chuanqichen/Hardware-Accelerated-Monte-Carlo-Simulation/docs/course/README.md

# Course materials (not committed)

This folder holds the ECE 382M-7 Fall 2026 handouts and example reports used while
planning the project. They are gitignored (large PDFs, course-owned content); get
them from the course Canvas page and drop them here with these names so the links in
`../Hardware_Accelerated_Monte_Carlo_Project_Plan.md` resolve:

- `2026Fall_VLSI_I_Class_Project.pdf` - project brief / "Final Project Information"
- `Overview of 2025 Project Submissions as a Guide for Project Selections.pdf`
- `Example Project Proposal.pdf`
- `Example Project Interim Report.pdf`
- `All_Digital_Versus_Mixed_Signal_Phase_Locked_Loops.pdf` - prior-year report
- `Project_export.zip` - sample-project archive
