chuanqichen/Hardware-Accelerated-Monte-Carlo-Simulation/docs/status/2026-10-31_handoff.md

# Status / handoff - Saturday 2026-10-31 (Chuanqi)

Snapshot of where the Gaussian-LUT + fixed-point work stands, what is in flight, and
what to do next. Written so the work can be resumed cold on Monday.

## Done this weekend (all in PR #4, branch `chuanqi/round-sat-mc-pkg`)

PR: https://github.com/chuanqichen/Hardware-Accelerated-Monte-Carlo-Simulation/pull/4
Reviewers requested: Eric (ericjgoode), Shentong (binton508), Tyler (makowski537).

| Item | Where | Evidence |
|---|---|---|
| Shared `round_sat` module (round-half-even, then saturate, `sat` flag; signed/unsigned; SHIFT=0 ok) | `rtl/round_sat.sv` | `tb_round_sat`: 12,067 signed + 11,552 unsigned vectors, 0 errors; `+lint=all` clean |
| Python twin | `fxp.round_sat()` | 23 tests in `model/test_round_sat.py` |
| Vectors + TB + make targets | `model/gen_round_sat_vectors.py`, `tb/tb_round_sat.sv`, `make gen-rs` / `make sim-rs` | |
| `round_sat` substituted into `price_dp` S2 (patch in PR body; Eric's file NOT modified) | `/tmp/price_dp_rs.sv` on laptop + peach | `tb_price_dp` bit-exact at `MUL_STAGES` 1 and 2 |
| Shared constants package | `rtl/mc_pkg.sv` | elaborates clean with every RTL file; `lat_total(1,1,1) = 9` |
| Integrated one-lane golden model | `model/mc_lane.py` (`run_lane`, `trace_lane`, `run_option`, `LaneConfig`) | 11 tests in `model/test_mc_lane.py` |
| Spec refreshed to merged RTL | `docs/Lane_Interface_Spec.md` | D-3/D-6 closed 2026-10-22; D-4/D-5 open |
| First VCS run of every block on `main` | `reports/vcs_regression_2026-10-31.txt` | 69 model tests + 11 TB runs, all PASS |
| Lab-server recipe | `AGENTS.md` (ECE lab server section) | |
| `gauss_lut.sv` assertion labelled (`a_mag_positive`) | `rtl/gauss_lut.sv:74` | lint clean |

Bugs found by VCS, fixed, and now covered by directed vectors (worth a line in the report):
1. `round_sat`: cast-to-compare-width before shifting truncated the high input bits.
2. `round_sat`: unsigned max magnitude landed in the signed compare's sign bit.

## Environment

- **peach**: `ssh -i ~/.ssh/id_ed25519_ece cc83382@peach.ece.utexas.edu`; repo at
  `~/382M.7/Hardware-Accelerated-Monte-Carlo-Simulation` (on `main` 3c4169b + the PR
  files copied by scp - do a `git fetch && git checkout chuanqi/round-sat-mc-pkg` to
  make it a real checkout). Tools: `bash -l -c 'module load syn/2022 && ...'`.
  Python: `export PYTHON=/home/work/cc83382/venv/bin/python`. Home quota 2 GB - keep
  `simv*`/`csrc` cleaned up.
- **gh**: logged in as chuanqichen (HTTPS). `git push` still uses the macOS keychain.
- **Laptop**: no simulator; `make test`, `make gen*`, `make sweep` all work.

## Open questions raised in the PR

- Eric: PR #3 (revert of #2) opened and closed in 21 s on 2026-10-27 - is #2 good as merged?
- Tyler: no `mc_top`, controller, DC script or SDC in the repo yet. Week 2 exit
  criterion (bit-exact one-lane RTL) and all Week 3 synthesis depend on it.

## Monday 2026-11-02 agenda

1. Tyler status; fallback = minimal `mc_lane_top` (RNG -> LUT -> DP -> ACC) by Eric or me.
2. Announce all blocks pass under VCS on peach; share the `AGENTS.md` recipe.
3. D-4 (`z` 16 vs 12 b) and D-5 (`A`/`x` 18 vs 16 b): defer to Week 3 synthesis, or fix baseline now.
4. Who owns `mc_lane.py` going forward (me vs Eric).
5. Makefile: `PYTHON=` override; make the VCS targets not depend on `gen-price`.

## Next for me (Week 3, Nov 2-7)

- [ ] Get PR #4 reviewed and merged; help Eric apply the `round_sat` patch.
- [ ] Synthesize `gauss_lut` standalone on peach: `ADDR_BITS = {8, 10, 12}` x `OUT_WIDTH = {12, 16}`.
      Needs a DC script (Tyler's or write one) -> `results/gauss_lut_ppa.csv`, raw reports in `reports/`.
      Closes D-4.
- [ ] Extend the exact-bias sweep through quantised `x`, `S_T`, `p` for D-5. Check
      `price_dp.sweep()` first - it already does most of this; may only need joining with
      the `ADDR_BITS` sweep.
- [ ] Integrated one-lane TB vs `mc_lane.run_lane()` once a top exists (100 / 1k / 10k
      trials, bubbles, reset/restart, no X on valid-qualified buses).
- [ ] Interim slides (due Nov 10): block description, Sec. 6 exact-bias table,
      tail-truncation headline, standalone PPA, D-4/D-5 status, VCS pass log.

## Useful commands

```bash
# laptop
make test && make gen-rs
python3 model/mc_lane.py                 # 10^5-trial run vs exact / Black-Scholes
# peach (login shell)
module load syn/2022; export PYTHON=/home/work/cc83382/venv/bin/python
make test; make sim LATENCY=1; make sim-rs; make sim-price
rm -rf simv* csrc                        # keep the home quota happy
```

## Tyler merge checkpoint, 2026-11-01

PR #6 fixed the false-pass round_sat gate and is merged. Tyler approved PR #4 after
69 model tests, original rounding vectors, and four failing-input checks; #4 is
merged. PR #5 was reviewed, approved and merged as the shared synthesis baseline,
with pre-layout power/Fmax and electrical-signoff limits explicit in the review.

The one-lane integration is on tyler/one-lane-integration. Original Week 1 dirty
checkout is preserved. The combined branch passes 88 full-top cases / 105,828
trials, 100 bubble trials, 30 mock-control runs and both rounding configurations.
Local checks: 69 model tests and 12 flow/parser tests. Full-top shared-flow synthesis
has +0.000509739 ns setup slack at 5 ns, with hold/capacitance violations remaining.
See docs/Integration_Work_Plan.md and results/one_lane_shared_5ns.csv.

The candidate cfg rules and current one-lane-only limit are documented. Gate-level
simulation, independent STA, physical cleanup and real 2/4-lane scaling remain.
No physical timing/power signoff or energy claim is made. Codex is completing the
integration publication for Tyler; keep a single writer until that merge is done.

## Tyler PR #8 fix handoff, 2026-11-02

Writer: Tyler/Codex, local branch tyler/accuracy-wave-fixes in .worktrees/pr8-review,
starting at PR #8 head 5349d07. The waveform runner now fails closed, retains
per-run builds/logs and preserves old plotting inputs on failure. The accuracy
plot uses the confidence interval of the across-run mean and clarifies software
variance and exact-hardware coverage. CSV results and production RTL are unchanged.
Replot with python model/price_study.py --plot-only.

Checks: 79 model tests, 14 flow tests including 24 waveform failure cases, and
all three actual VCS waveform testbenches pass. See
reports/pr8_fix_validation_2026-11-02.txt for counts and the compiler-helper caveat.
Original dirty checkout and previous review evidence are preserved. Writer released
after the local commit; next action is publishing the fix branch for PR #8 review.
Nothing from this fix has been pushed, merged or approved remotely.

## Tyler interim checkpoint, 2026-11-11

Writer: Tyler/Codex on tyler/interim-integration-update in .worktrees/interim-update,
starting from main a83501c after PRs #8 and #10 merged. Original dirty Week 1 and
all earlier worktrees/evidence are preserved. Scope: interface-only mapped replay,
independent pre-layout STA, current integration docs and report contribution.

Verified: 85 model tests, 21 flow tests, fresh DC synthesis, and mapped replay of
22 cases / 26,457 trials. Corrupt sums, an empty corpus and an invalid SDC fail.
The important new limit is PrimeTime setup slack -0.200381 ns at the 5 ns target,
despite DC +0.000509739 ns. Hold/electrical/coverage issues also remain. See
reports/interim_validation_2026-11-11.txt and docs/Interim_Integration_Contribution.md.

Report assembly stays with Shentong; the Google Doc and Slack were read only.
Next: publish this isolated update for review, reconcile the timing discrepancy,
classify coverage and proceed with the proposed physical/multi-lane schedule.

## Shared report review, 2026-11-12

Tyler/Codex accepted Shentong's Slack invitation to edit the shared report directly.
The integration/synthesis claims were checked against PR #11's evidence, and the
feedback response now states exact-hardware CI coverage and conditional throughput.
The full-module screenshot was replaced with a short native baseline RTL excerpt;
seven equations and the responsibilities table were preserved. The final seven-page
PDF render was checked, including the fixed table/page flow. Shared source:
https://docs.google.com/document/d/1isvrOuPwzOCb3ohCs8GTmFbX7jLQcdSlMBD0RpaKZDk/edit

Repository edits are documentation only on tyler/interim-integration-update, after
7ff1989. Production source and evidence remain unchanged. No hardware tests were
repeated for report edits. No Slack message was sent. Writer released after this
handoff; Shentong retains report assembly and submission. PR #11 is still a draft;
the timing-engine discrepancy remains the next engineering task.

## Gaussian address clarification, 2026-11-13

Chuanqi requested the rationale and validation of the 10-bit address in Slack;
Tyler accepted. The shared report now explains `u[31:22]`, 1,024 bins and 512 stored
16-bit magnitudes, with the matched 8/10/12-bit full-chain bias and standalone area
tradeoff. All 15 relevant pricing rows reproduced; all 1,024 midpoint addresses and
the 11,029-vector corpus matched the model. Existing VCS evidence covers LATENCY
1 and 2; no new simulator run was needed. The rendered report remains seven pages,
with all seven equations and the responsibilities table preserved.

The report's accidental past-tense claim of multi-lane/layout completion was
restored to planned work. Scope is documentation only on
tyler/interim-integration-update after f05e4f0. The original dirty checkout, RTL and
result files remain untouched. Writer released; Shentong retains final report
assembly. No Slack message was sent. Timing reconciliation remains open.
