chuanqichen/Hardware-Accelerated-Monte-Carlo-Simulation/docs/figures/wave_price_dp.png

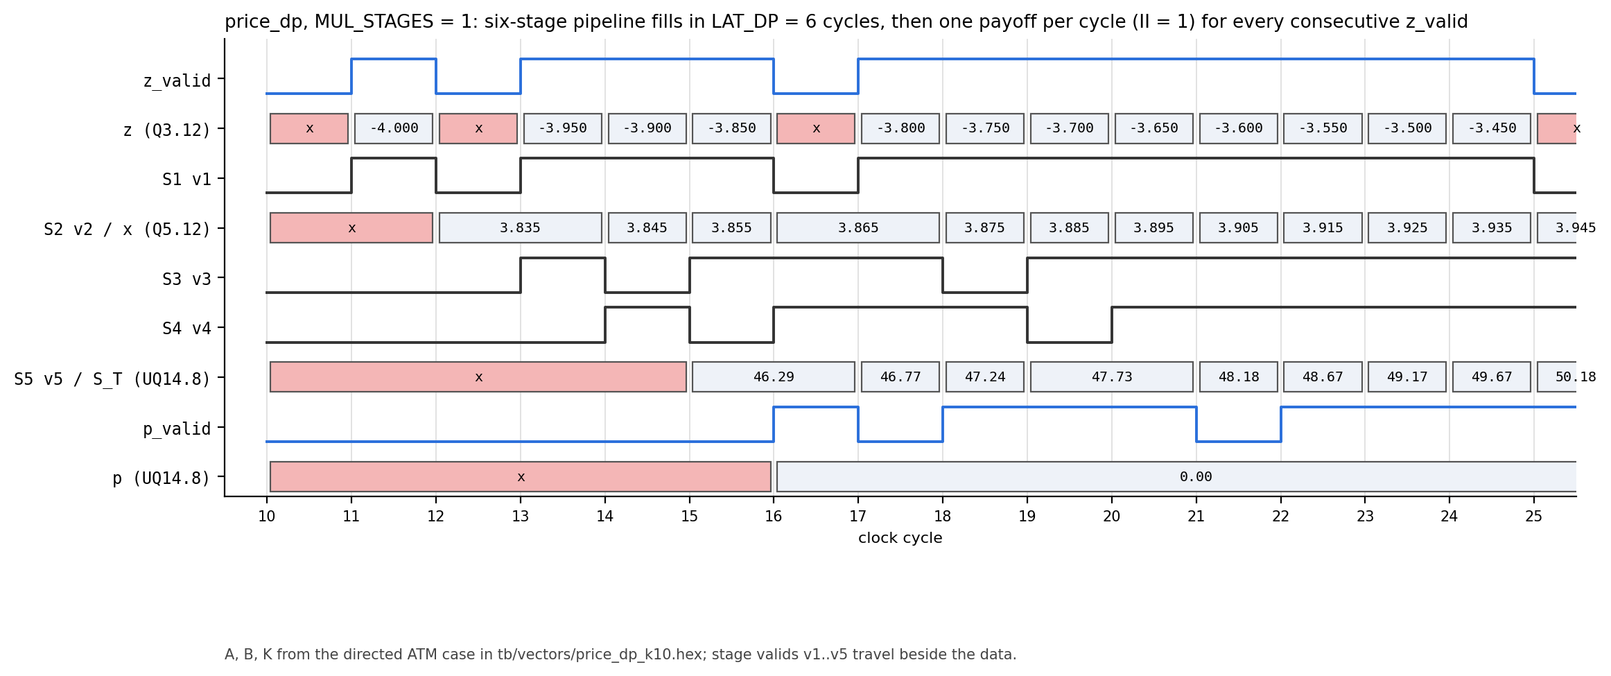
docs/figures/wave_price_dp.png
