chuanqichen/Hardware-Accelerated-Monte-Carlo-Simulation/docs/references/citation_validation_20260920_hardware_monte_carlo.md

# Citation validation report

Validated against the Crossref Works API on 2026-09-20. All 16 queried DOIs resolved with HTTP 200 and returned matching titles.

| DOI | Year | Title | Venue |
|---|---:|---|---|
| `10.1145/3447818.3461664` | 2021 | ThundeRiNG: Generating Multiple Independent Random Number Sequences on FPGAs | ACM International Conference on Supercomputing |
| `10.1109/EMS.2016.036` | 2016 | High Performance and Low Power Monte Carlo Methods to Option Pricing Models via High Level Design and Synthesis | European Modelling Symposium |
| `10.23919/DATE58400.2024.10546516` | 2024 | TreeGRNG: Binary Tree Gaussian Random Number Generator for Efficient Probabilistic AI Hardware | DATE |
| `10.1016/j.cpc.2026.110394` | 2026 | FPGA Acceleration of Matrix-Element Calculations for Monte Carlo Event Generation | Computer Physics Communications |
| `10.3390/electronics13163186` | 2024 | The Role of FPGAs in Modern Option Pricing Techniques: A Survey | Electronics |
| `10.1109/TC.2006.81` | 2006 | A Hardware Gaussian Noise Generator Using the Box-Muller Method and Its Error Analysis | IEEE Transactions on Computers |
| `10.1109/ASAP.2008.4580163` | 2008 | Low Discrepancy Sequences for Monte Carlo Simulations on Reconfigurable Platforms | ASAP |
| `10.1109/FPT.2014.7082755` | 2014 | FPGA-Accelerated Monte-Carlo Integration Using Stratified Sampling and Brownian Bridges | FPT |
| `10.1155/2012/675130` | 2012 | A Hardware Efficient Random Number Generator for Nonuniform Distributions with Arbitrary Precision | International Journal of Reconfigurable Computing |
| `10.1109/ReConFig.2011.11` | 2011 | An Energy Efficient FPGA Accelerator for Monte Carlo Option Pricing with the Heston Model | ReConFig |
| `10.7873/DATE.2013.063` | 2013 | A Multi-Level Monte Carlo FPGA Accelerator for Option Pricing in the Heston Model | DATE |
| `10.1145/1268776.1268777` | 2007 | TestU01: A C Library for Empirical Testing of Random Number Generators | ACM Transactions on Mathematical Software |
| `10.1145/2063384.2063405` | 2011 | Parallel Random Numbers: As Easy as 1, 2, 3 | SC |
| `10.18637/jss.v008.i14` | 2003 | Xorshift RNGs | Journal of Statistical Software |
| `10.1086/260062` | 1973 | The Pricing of Options and Corporate Liabilities | Journal of Political Economy |
| `10.1093/rfs/6.2.327` | 1993 | A Closed-Form Solution for Options with Stochastic Volatility with Applications to Bond and Currency Options | Review of Financial Studies |

The bundled citation-management validator could not parse the Crossref-generated one-line BibTeX entries and crashed after reporting zero parsed entries. DOI resolution and metadata matching were therefore verified directly through Crossref; the raw BibTeX output is preserved separately.
