chuanqichen/Hardware-Accelerated-Monte-Carlo-Simulation/results/d5_x_width.csv

addr_bits | x_fmt | x_width | x_frac | option | bs | float_ref | hw | bias_vs_float_pct | bias_vs_bs_pct
8 | Q5.12 (18b) | 18 | 12 | ITM K=80 s=0.2 | 24.58883544392775 | 24.574364829467598 | 24.582856457338757 | 0.03455482137620254 | -0.024315859133007704
8 | Q5.12 (18b) | 18 | 12 | ATM K=100 s=0.2 | 10.450583572185565 | 10.436192198016933 | 10.44189690189149 | 0.05466269465256274 | -0.08312138967239181
8 | Q5.12 (18b) | 18 | 12 | OTM K=120 s=0.2 | 3.247477416560809 | 3.2330305448533454 | 3.235320891580714 | 0.0708420998686355 | -0.37433747554645624
8 | Q5.12 (18b) | 18 | 12 | ATM K=100 s=0.6 | 25.523205665609503 | 25.383723336041815 | 25.380724521682083 | -0.011813926270908924 | -0.5582415696293254
8 | Q5.12 (18b) | 18 | 12 | OTM K=150 s=0.6 | 11.946999829891489 | 11.807134760276773 | 11.806226617083043 | -0.007691478179659427 | -1.1783143451314873
8 | Q5.11 (17b) | 17 | 11 | ITM K=80 s=0.2 | 24.58883544392775 | 24.574364829467598 | 24.581230821115245 | 0.027939650506913057 | -0.030927136951426366
8 | Q5.11 (17b) | 17 | 11 | ATM K=100 s=0.2 | 10.450583572185565 | 10.436192198016933 | 10.442404913211337 | 0.059530478900007455 | -0.07826030879265793
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
