chuanqichen/Hardware-Accelerated-Monte-Carlo-Simulation/results/rng_20261108_lags.csv

origin | stream | seed_bus | lag | correlation | screen_limit
imported_hex_canonical_checked | 0 | 0123456789abcdef0fedcba987654321 | 1 | 0.0005725882247458853 | 0.005859377793969722
imported_hex_canonical_checked | 0 | 0123456789abcdef0fedcba987654321 | 2 | 0.0005087849146128293 | 0.005859380587943441
imported_hex_canonical_checked | 0 | 0123456789abcdef0fedcba987654321 | 4 | 0.0011368024305010054 | 0.00585938617590287
imported_hex_canonical_checked | 0 | 0123456789abcdef0fedcba987654321 | 8 | 0.0008482255705019332 | 0.005859397351869689
imported_hex_canonical_checked | 0 | 0123456789abcdef0fedcba987654321 | 16 | -0.0005303004954892163 | 0.005859419703995179
imported_hex_canonical_checked | 1 | a21ddd67452a68254e0d1fe67c4a7a02 | 1 | 0.0015552892225936363 | 0.005859377793969722
imported_hex_canonical_checked | 1 | a21ddd67452a68254e0d1fe67c4a7a02 | 2 | 0.0007816454274062214 | 0.005859380587943441
imported_hex_canonical_checked | 1 | a21ddd67452a68254e0d1fe67c4a7a02 | 4 | -0.0015023908261074506 | 0.00585938617590287
imported_hex_canonical_checked | 1 | a21ddd67452a68254e0d1fe67c4a7a02 | 8 | 0.0008921478687228803 | 0.005859397351869689
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
