chuanqichen/Hardware-Accelerated-Monte-Carlo-Simulation/results/rng_model_bits.csv

origin | stream | seed_bus | bit | ones | fraction | z_score
python_model | 0 | 0123456789abcdef0fedcba987654321 | 0 | 523403 | 0.49915599822998047 | -1.728515625
python_model | 0 | 0123456789abcdef0fedcba987654321 | 1 | 524130 | 0.4998493194580078 | -0.30859375
python_model | 0 | 0123456789abcdef0fedcba987654321 | 2 | 524181 | 0.49989795684814453 | -0.208984375
python_model | 0 | 0123456789abcdef0fedcba987654321 | 3 | 524053 | 0.49977588653564453 | -0.458984375
python_model | 0 | 0123456789abcdef0fedcba987654321 | 4 | 524504 | 0.5002059936523438 | 0.421875
python_model | 0 | 0123456789abcdef0fedcba987654321 | 5 | 524439 | 0.5001440048217773 | 0.294921875
python_model | 0 | 0123456789abcdef0fedcba987654321 | 6 | 525504 | 0.50115966796875 | 2.375
python_model | 0 | 0123456789abcdef0fedcba987654321 | 7 | 524046 | 0.4997692108154297 | -0.47265625
python_model | 0 | 0123456789abcdef0fedcba987654321 | 8 | 524018 | 0.4997425079345703 | -0.52734375
python_model | 0 | 0123456789abcdef0fedcba987654321 | 9 | 523985 | 0.4997110366821289 | -0.591796875
python_model | 0 | 0123456789abcdef0fedcba987654321 | 10 | 524933 | 0.500615119934082 | 1.259765625
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
