chuanqichen/Hardware-Accelerated-Monte-Carlo-Simulation/results/rng_20261108_quality.png

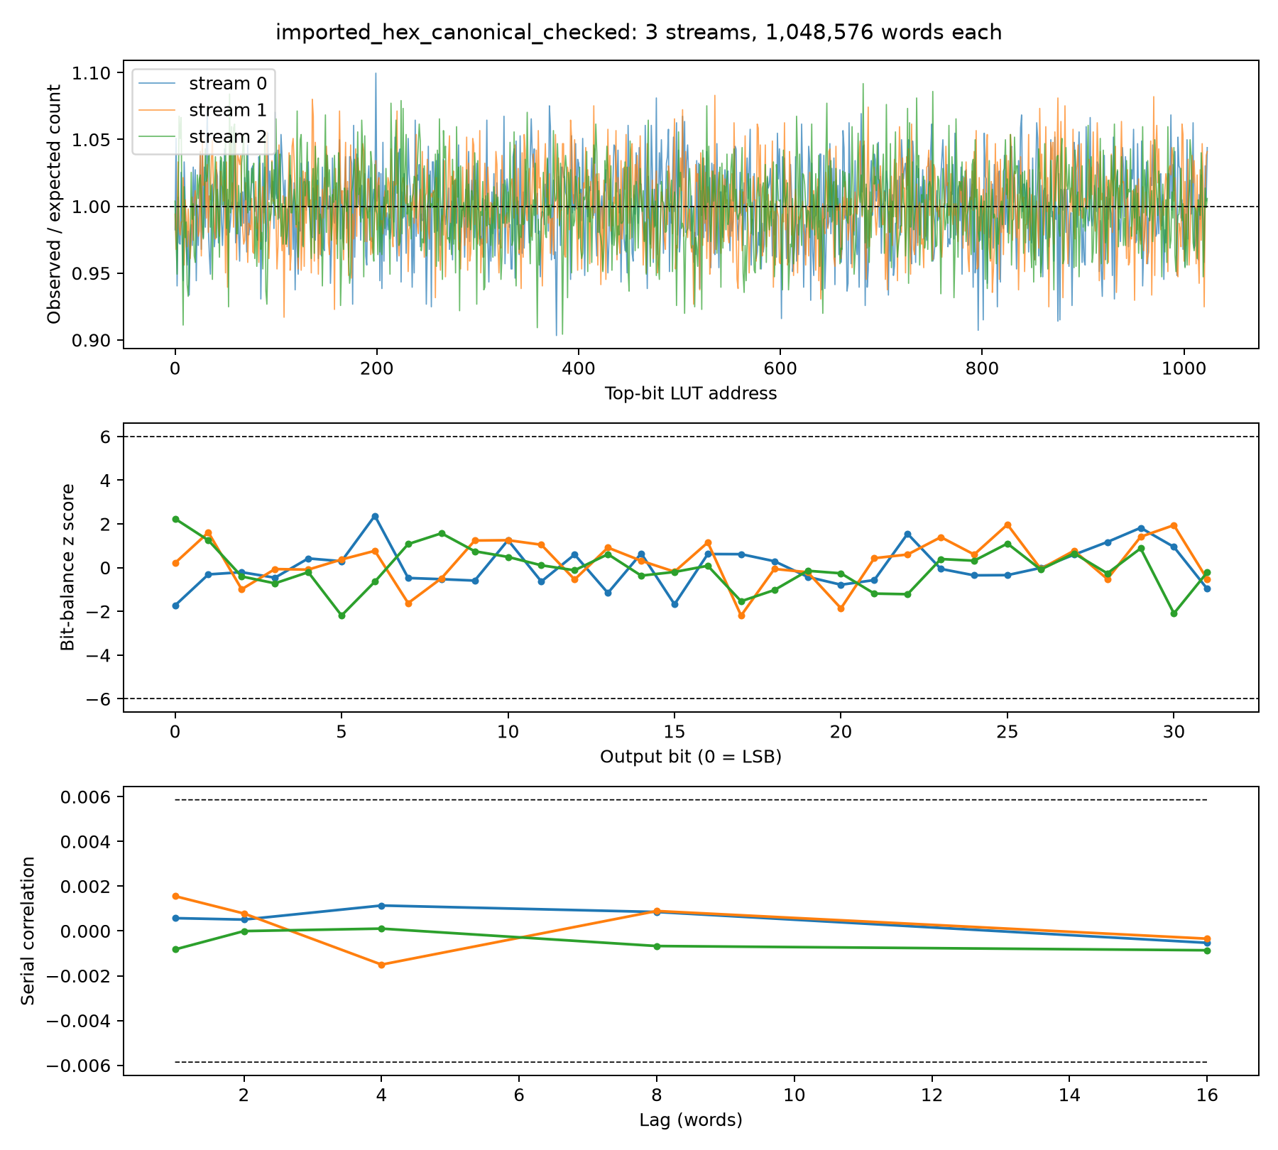
results/rng_20261108_quality.png
