chuanqichen/Hardware-Accelerated-Monte-Carlo-Simulation/reports/syn/gauss_lut_a10_w12_l1/gauss_lut.mapped.v

/////////////////////////////////////////////////////////////
// Created by: Synopsys DC Ultra(TM) in wire load mode
// Version   : T-2022.03-SP2
// Date      : Sun Nov  1 06:37:22 2026
/////////////////////////////////////////////////////////////


module gauss_lut_rom_ADDR_BITS10_OUT_WIDTH12 ( j, mag );
  input [8:0] j;
  output [11:0] mag;
  wire   n1112, n1113, n1114, n1115, n1, n2, n3, n4, n5, n6, n7, n8, n9, n10,
         n11, n12, n13, n14, n15, n16, n17, n18, n19, n20, n21, n22, n23, n24,
         n25, n26, n27, n28, n29, n30, n31, n32, n33, n34, n35, n36, n37, n39,
         n40, n41, n42, n43, n44, n45, n47, n49, n51, n53, n54, n55, n57, n59,
         n60, n61, n62, n63, n64, n65, n67, n68, n70, n72, n73, n75, n76, n78,
         n79, n81, n82, n84, n85, n87, n88, n89, n90, n91, n92, n93, n94, n95,
         n96, n97, n98, n99, n100, n101, n102, n103, n104, n105, n106, n107,
         n108, n109, n110, n111, n112, n114, n115, n116, n117, n119, n122,
         n124, n125, n127, n128, n129, n130, n132, n133, n135, n136, n137,
         n138, n139, n142, n144, n146, n148, n149, n150, n151, n152, n153,
         n154, n155, n156, n157, n158, n159, n160, n161, n162, n163, n164,
         n165, n166, n167, n168, n169, n170, n171, n172, n173, n174, n175,
         n176, n177, n178, n179, n180, n181, n182, n183, n184, n185, n186,
         n187, n188, n189, n190, n191, n192, n193, n194, n195, n196, n197,
         n198, n199, n200, n201, n202, n203, n204, n205, n206, n207, n208,
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
  AND2X1 U101 ( .A(n1134), .B(n299), .Y(n44) );
  INVX1 U102 ( .A(n517), .Y(n1135) );
  AND2X1 U103 ( .A(n842), .B(n1135), .Y(n57) );
  OR2X1 U104 ( .A(n783), .B(n776), .Y(n517) );
  OR2X2 U105 ( .A(n619), .B(n139), .Y(n319) );
  AND2X1 U106 ( .A(n360), .B(j[7]), .Y(n139) );
endmodule


module gauss_lut ( clk, rst_n, in_valid, u, out_valid, z );
  input [31:0] u;
  output [11:0] z;
  input clk, rst_n, in_valid;
  output out_valid;
  wire   n159, N14, n51, n52, n53, n54, n55, n56, n57, n58, n59, n60, n61, n62,
         n64, n65, n66, n67, n68, n69, n70, n71, n72, n73, n74, n75, n76, n77,
         n78, n79, n80, n81, n82, n83, n84, n85, n86, n87, n88, n89, n90, n91,
         n92, n93, n94, n95, n96, n97, n98, n99, n100, n101, n102, n103, n104,
         n105, n107, n108, n109, n110, n111, n112, n113, n114, n115, n116,
         n117, n118, n119, n120, n121, n122, n123, n124, n125, n126, n127,
         n128, n129, n130, n131, n132, n133, n134, n135, n136, n137, n138,
         n139, n140, n141, n142, n143, n144, n145, n146, n147, n148, n149,
         n150, n151, n152, n153, n154, n155, n156, n157, n158,
         SYNOPSYS_UNCONNECTED_1, SYNOPSYS_UNCONNECTED_2;
  wire   [8:0] j;
  wire   [9:1] mag;

  gauss_lut_rom_ADDR_BITS10_OUT_WIDTH12 u_rom ( .j(j), .mag({
        SYNOPSYS_UNCONNECTED_1, SYNOPSYS_UNCONNECTED_2, mag, N14}) );
  DFFSR out_valid_reg ( .D(in_valid), .CLK(clk), .R(rst_n), .S(1'b1), .Q(n159)
         );
  DFFPOSX1 z_reg_11_ ( .D(n62), .CLK(clk), .Q(z[11]) );
  DFFPOSX1 z_reg_10_ ( .D(n61), .CLK(clk), .Q(z[10]) );
  DFFPOSX1 z_reg_9_ ( .D(n65), .CLK(clk), .Q(z[9]) );
  DFFPOSX1 z_reg_8_ ( .D(n68), .CLK(clk), .Q(z[8]) );
  DFFPOSX1 z_reg_7_ ( .D(n71), .CLK(clk), .Q(z[7]) );
  DFFPOSX1 z_reg_6_ ( .D(n74), .CLK(clk), .Q(z[6]) );
  DFFPOSX1 z_reg_5_ ( .D(n77), .CLK(clk), .Q(z[5]) );
  DFFPOSX1 z_reg_4_ ( .D(n80), .CLK(clk), .Q(z[4]) );
  DFFPOSX1 z_reg_3_ ( .D(n83), .CLK(clk), .Q(z[3]) );
  DFFPOSX1 z_reg_2_ ( .D(n86), .CLK(clk), .Q(z[2]) );
  DFFPOSX1 z_reg_1_ ( .D(n89), .CLK(clk), .Q(z[1]) );
  DFFPOSX1 z_reg_0_ ( .D(n92), .CLK(clk), .Q(z[0]) );
  INVX1 U75 ( .A(n66), .Y(n64) );
  INVX1 U76 ( .A(n64), .Y(n65) );
  BUFX2 U77 ( .A(n60), .Y(n66) );
  INVX1 U78 ( .A(n69), .Y(n67) );
  INVX1 U79 ( .A(n67), .Y(n68) );
  BUFX2 U80 ( .A(n59), .Y(n69) );
  INVX1 U81 ( .A(n72), .Y(n70) );
  INVX1 U82 ( .A(n70), .Y(n71) );
  BUFX2 U83 ( .A(n58), .Y(n72) );
  INVX1 U84 ( .A(n75), .Y(n73) );
  INVX1 U85 ( .A(n73), .Y(n74) );
  BUFX2 U86 ( .A(n57), .Y(n75) );
  INVX1 U87 ( .A(n78), .Y(n76) );
  INVX1 U88 ( .A(n76), .Y(n77) );
  BUFX2 U89 ( .A(n56), .Y(n78) );
  INVX1 U90 ( .A(n81), .Y(n79) );
  INVX1 U91 ( .A(n79), .Y(n80) );
  BUFX2 U92 ( .A(n55), .Y(n81) );
  INVX1 U93 ( .A(n84), .Y(n82) );
  INVX1 U94 ( .A(n82), .Y(n83) );
  BUFX2 U95 ( .A(n54), .Y(n84) );
  INVX1 U96 ( .A(n87), .Y(n85) );
  INVX1 U97 ( .A(n85), .Y(n86) );
  BUFX2 U98 ( .A(n53), .Y(n87) );
  INVX1 U99 ( .A(n90), .Y(n88) );
  INVX1 U100 ( .A(n88), .Y(n89) );
  BUFX2 U101 ( .A(n52), .Y(n90) );
  INVX1 U102 ( .A(n93), .Y(n91) );
  INVX1 U103 ( .A(n91), .Y(n92) );
  BUFX2 U104 ( .A(n51), .Y(n93) );
  OR2X1 U105 ( .A(mag[7]), .B(n122), .Y(n117) );
  OR2X1 U106 ( .A(mag[4]), .B(n103), .Y(n132) );
  OR2X1 U107 ( .A(n112), .B(mag[9]), .Y(n108) );
  BUFX2 U108 ( .A(n110), .Y(n94) );
  AND2X1 U109 ( .A(n151), .B(n112), .Y(n113) );
  INVX1 U110 ( .A(n113), .Y(n95) );
  AND2X1 U111 ( .A(n151), .B(n117), .Y(n118) );
  INVX1 U112 ( .A(n118), .Y(n96) );
  AND2X1 U113 ( .A(n151), .B(n122), .Y(n123) );
  INVX1 U114 ( .A(n123), .Y(n97) );
  AND2X1 U115 ( .A(n151), .B(n104), .Y(n128) );
  INVX1 U116 ( .A(n128), .Y(n98) );
  OR2X1 U117 ( .A(u[31]), .B(n105), .Y(n133) );
  INVX1 U118 ( .A(n133), .Y(n99) );
  AND2X1 U119 ( .A(n151), .B(n103), .Y(n138) );
  INVX1 U120 ( .A(n138), .Y(n100) );
  OR2X1 U121 ( .A(u[31]), .B(n142), .Y(n143) );
  INVX1 U122 ( .A(n143), .Y(n101) );
  AND2X1 U123 ( .A(N14), .B(n151), .Y(n152) );
  INVX1 U124 ( .A(n152), .Y(n102) );
  AND2X1 U125 ( .A(n142), .B(n144), .Y(n137) );
  INVX1 U126 ( .A(n137), .Y(n103) );
  AND2X1 U127 ( .A(n105), .B(n134), .Y(n127) );
  INVX1 U128 ( .A(n127), .Y(n104) );
  INVX1 U129 ( .A(n132), .Y(n105) );
  BUFX2 U130 ( .A(n159), .Y(out_valid) );
  INVX1 U131 ( .A(u[31]), .Y(n107) );
  INVX1 U132 ( .A(u[31]), .Y(n151) );
  MUX2X1 U133 ( .B(u[31]), .A(n151), .S(u[22]), .Y(j[0]) );
  MUX2X1 U134 ( .B(u[31]), .A(n151), .S(u[23]), .Y(j[1]) );
  MUX2X1 U135 ( .B(u[31]), .A(n151), .S(u[24]), .Y(j[2]) );
  MUX2X1 U136 ( .B(u[31]), .A(n151), .S(u[25]), .Y(j[3]) );
  MUX2X1 U137 ( .B(u[31]), .A(n151), .S(u[26]), .Y(j[4]) );
  MUX2X1 U138 ( .B(u[31]), .A(n151), .S(u[27]), .Y(j[5]) );
  MUX2X1 U139 ( .B(u[31]), .A(n107), .S(u[28]), .Y(j[6]) );
  MUX2X1 U140 ( .B(u[31]), .A(n151), .S(u[29]), .Y(j[7]) );
  MUX2X1 U141 ( .B(u[31]), .A(n151), .S(u[30]), .Y(j[8]) );
  INVX1 U143 ( .A(z[11]), .Y(n109) );
  NOR3X1 U144 ( .A(mag[2]), .B(N14), .C(mag[1]), .Y(n142) );
  INVX1 U145 ( .A(mag[3]), .Y(n144) );
  INVX1 U146 ( .A(mag[5]), .Y(n134) );
  OR2X1 U147 ( .A(mag[6]), .B(n104), .Y(n122) );
  OR2X1 U148 ( .A(mag[8]), .B(n117), .Y(n112) );
  NAND3X1 U149 ( .A(n151), .B(in_valid), .C(n108), .Y(n110) );
  OAI21X1 U150 ( .A(in_valid), .B(n109), .C(n94), .Y(n62) );
  INVX1 U151 ( .A(z[10]), .Y(n111) );
  OAI21X1 U152 ( .A(in_valid), .B(n111), .C(n94), .Y(n61) );
  INVX1 U153 ( .A(mag[9]), .Y(n114) );
  MUX2X1 U154 ( .B(n114), .A(mag[9]), .S(n95), .Y(n116) );
  INVX1 U155 ( .A(z[9]), .Y(n115) );
  INVX1 U156 ( .A(in_valid), .Y(n156) );
  AOI22X1 U157 ( .A(in_valid), .B(n116), .C(n115), .D(n156), .Y(n60) );
  INVX1 U158 ( .A(mag[8]), .Y(n119) );
  MUX2X1 U159 ( .B(n119), .A(mag[8]), .S(n96), .Y(n121) );
  INVX1 U160 ( .A(z[8]), .Y(n120) );
  AOI22X1 U161 ( .A(in_valid), .B(n121), .C(n120), .D(n156), .Y(n59) );
  INVX1 U162 ( .A(mag[7]), .Y(n124) );
  MUX2X1 U163 ( .B(n124), .A(mag[7]), .S(n97), .Y(n126) );
  INVX1 U164 ( .A(z[7]), .Y(n125) );
  AOI22X1 U165 ( .A(in_valid), .B(n126), .C(n125), .D(n156), .Y(n58) );
  INVX1 U166 ( .A(mag[6]), .Y(n129) );
  MUX2X1 U167 ( .B(n129), .A(mag[6]), .S(n98), .Y(n131) );
  INVX1 U168 ( .A(z[6]), .Y(n130) );
  AOI22X1 U169 ( .A(in_valid), .B(n131), .C(n130), .D(n156), .Y(n57) );
  MUX2X1 U170 ( .B(mag[5]), .A(n134), .S(n99), .Y(n136) );
  INVX1 U171 ( .A(z[5]), .Y(n135) );
  AOI22X1 U172 ( .A(in_valid), .B(n136), .C(n135), .D(n156), .Y(n56) );
  INVX1 U173 ( .A(mag[4]), .Y(n139) );
  MUX2X1 U174 ( .B(n139), .A(mag[4]), .S(n100), .Y(n141) );
  INVX1 U175 ( .A(z[4]), .Y(n140) );
  AOI22X1 U176 ( .A(in_valid), .B(n141), .C(n140), .D(n156), .Y(n55) );
  MUX2X1 U177 ( .B(mag[3]), .A(n144), .S(n101), .Y(n146) );
  INVX1 U178 ( .A(z[3]), .Y(n145) );
  AOI22X1 U179 ( .A(in_valid), .B(n146), .C(n145), .D(n156), .Y(n54) );
  INVX1 U180 ( .A(mag[2]), .Y(n148) );
  OAI21X1 U181 ( .A(N14), .B(mag[1]), .C(n151), .Y(n147) );
  MUX2X1 U182 ( .B(n148), .A(mag[2]), .S(n147), .Y(n150) );
  INVX1 U183 ( .A(z[2]), .Y(n149) );
  AOI22X1 U184 ( .A(in_valid), .B(n150), .C(n149), .D(n156), .Y(n53) );
  INVX1 U185 ( .A(mag[1]), .Y(n153) );
  MUX2X1 U186 ( .B(n153), .A(mag[1]), .S(n102), .Y(n155) );
  INVX1 U187 ( .A(z[1]), .Y(n154) );
  AOI22X1 U188 ( .A(in_valid), .B(n155), .C(n154), .D(n156), .Y(n52) );
  INVX1 U189 ( .A(N14), .Y(n158) );
  INVX1 U190 ( .A(z[0]), .Y(n157) );
  AOI22X1 U191 ( .A(in_valid), .B(n158), .C(n157), .D(n156), .Y(n51) );
endmodule
