chuanqichen/Hardware-Accelerated-Monte-Carlo-Simulation/tb/tb_rng_lane.sv

// Cycle-exact checks after NBA updates: valid, output (even on hold), state.
// Optional +STREAM_FILE=<path> exports valid raw words as one hex word/line.
`timescale 1ns/1ps
module tb_rng_lane;
  parameter string VEC_FILE = "tb/vectors/rng_lane.hex";
  logic clk = 1'b0;
  logic rst_n = 1'b0, seed_load = 1'b0, run = 1'b0;
  logic [127:0] seed_state = '0;
  logic [31:0] u;
  logic u_valid;
  rng_lane dut (.*);
  always #5 clk = ~clk;

  initial begin : watchdog
    #1000000;
    $fatal(1, "RNG test timeout");
  end

  initial begin : test
    int fd, fields, n_cycles, n_valid, stream_fd, chars;
    logic vec_rst_n, vec_load, vec_run, exp_valid;
    logic [127:0] vec_seed, exp_state;
    logic [31:0] exp_u;
    string stream_file, line;
    n_cycles = 0;
    n_valid = 0;
    stream_fd = 0;
    if (dut.LAT_RNG != 1) $fatal(1, "LAT_RNG must be 1");
    if ($value$plusargs("STREAM_FILE=%s", stream_file)) begin
      stream_fd = $fopen(stream_file, "w");
      if (!stream_fd) $fatal(1, "cannot open stream output %s", stream_file);
    end
    fd = $fopen(VEC_FILE, "r");
    if (!fd) $fatal(1, "cannot open vectors %s", VEC_FILE);

    // Explicit asynchronous reset check BETWEEN edges during active operation.
    @(negedge clk);
    rst_n = 1'b1; seed_load = 1'b1; run = 1'b1;
    seed_state = 128'h00000004000000030000000200000001;
    @(posedge clk); #1;
    @(negedge clk); seed_load = 1'b0;
    @(posedge clk); #1;
    if (u_valid !== 1'b1 || u !== 32'h00000281)
      $fatal(1, "canonical first sample or load priority failed");
    #1; rst_n = 1'b0; seed_load = 1'b1; // run and load still high
    #1;
    if (u_valid !== 1'b0 || u !== '0 || {dut.s3,dut.s2,dut.s1,dut.s0} !== '0)
      $fatal(1, "asynchronous reset did not clear registers immediately");

    // Read complete rows so EOF cannot masquerade as malformed input.
    while (1) begin
      chars = $fgets(line, fd);
      if (chars == 0) break;
      fields = $sscanf(line, "%h %h %h %h %h %h %h",
                       vec_rst_n, vec_load, vec_run, vec_seed,
                       exp_valid, exp_u, exp_state);
      if (fields != 7) $fatal(1, "malformed vector row %0d (%0d fields)", n_cycles, fields);
      @(negedge clk);
      rst_n = vec_rst_n;
      seed_load = vec_load;
      run = vec_run;
      seed_state = vec_seed;
      @(posedge clk); #1;
      if (u_valid !== exp_valid || u !== exp_u ||
          {dut.s3,dut.s2,dut.s1,dut.s0} !== exp_state)
        $fatal(1, "cycle %0d: valid=%b/%b u=%h/%h state=%h/%h",
               n_cycles, u_valid, exp_valid, u, exp_u,
               {dut.s3,dut.s2,dut.s1,dut.s0}, exp_state);
      if (u_valid) begin
        n_valid++;
        if (stream_fd) $fdisplay(stream_fd, "%08h", u);
      end
      n_cycles++;
    end
    $fclose(fd);
    if (stream_fd) $fclose(stream_fd);
    if (n_cycles == 0 || n_valid == 0) $fatal(1, "empty RNG regression");
    $display("PASS rng_lane: %0d cycles, %0d valid words", n_cycles, n_valid);
    $finish;
  end
endmodule
