chuanqichen/Hardware-Accelerated-Monte-Carlo-Simulation/(commit log)

2026-10-03 Add revised proposal, Gaussian LUT model/RTL, and EDA project layout
    Record the narrowed team proposal (single-step European call, xoshiro RNG,
    inverse-normal LUT, 1/2/4 lanes) alongside the earlier research plan, and
    start the Gaussian lookup / fixed-point block: bit-accurate Python model with
    exact distribution stats and option-price bias, generated case-statement ROM,
    parameterized RTL, self-checking testbench, and a work plan with the sweep
    results (address bits dominate; tail truncation is the main error).
    Reorganize into a standard EDA layout (docs/course, docs/references, model,
    rtl, tb, scripts, constraints, reports, results) with a Makefile entry point.
    Course handouts and generate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
    [tb_gauss_lut.sv]
2026-10-03 Add draft lane interface spec for one-lane integration
    Defines every inter-block signal, fixed-point format, latency parameter,
    valid-chaining rule, the top-level cfg/result interface, controller
    sequence, Python reference contract, and the open decisions the team must
    close before integration RTL is written. Also drop the duplicated title in
    generated PDFs.
    Generated with [Devin](https://devin.ai)
2026-10-22 Add pricing datapath (price_dp) and accumulator with bit-accurate model
    Python reference first, then RTL checked bit for bit against generated vectors.
    - model/price_dp.py: fused MAC, single-rounding x, range-reduction exp
    (EXP_ADDR_BITS parameter), payoff, accumulator model, k sweep and
    exact price-bias vs Black-Scholes; fxp.py gains round_shift_even/saturate
    - rtl: price_dp (LAT_DP = MUL_STAGES + 5), exp2_unit + generated exp2_rom,
    accumulator (LANES-wide ports, popcount count, sticky flags), pipe
    - tb: self-checking tb_exp2_unit (exhaustive 2^18 x), tb_price_dp,
    tb_accumulator; make gen-price / sim-iv (Icarus) / sim-price (VCS)
    - docs/Pricing_Datapath_Work_Plan.md: design rationa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
2026-11-01 Add shared round_sat module with Python twin and VCS testbench
    One combinational narrowing operator for every fixed-point reduction in
    the lane: drop SHIFT fraction bits with round-half-to-even, then saturate
    the rounded value to OUT_WIDTH and flag it. Parameterised for signed (Q)
    and unsigned (UQ) formats and SHIFT = 0. fxp.round_sat() is the bit-exact
    twin, composed from the existing round_shift_even and Fxp.saturate.
    Verified under VCS on peach: 12,067 signed (34->18, shift 14, the
    price_dp S2 case) and 11,552 unsigned (26->16, shift 8) vectors, 0
    errors, +lint=all clean. Substituting the module for price_dp's inline
    S2 rounding reproduces all 11,449 tb_price_dp trials and both saturatio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
2026-11-01 Add mc_pkg shared constants and the integrated one-lane Python reference
    rtl/mc_pkg.sv is the single source for the lane's fixed-point widths,
    block latencies (constants plus lat_dp/lat_gauss/lat_tree/lat_total for
    the parameter-dependent ones), status bit positions and the configuration
    register map. Per-experiment knobs stay as module parameters so one
    synthesis run per configuration still works. Elaborates clean with
    +lint=all alongside every existing RTL file; lat_dp(1) = 6 and
    lat_total(1,1,1) = 9 match the measured block latencies.
    model/mc_lane.py chains the block owners' pure functions
    (rng_lane.next_word -> GaussLut.lookup -> price_dp.price_dp ->
    price_dp.accumulate) into run_lane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
2026-11-01 Update lane spec to the merged RTL; record VCS regression and lab-server notes
    Lane_Interface_Spec: measured latencies in Section 6 (LAT_TOTAL = 9 for
    one lane at defaults), price_dp's implemented stage table and single
    fused rounding in 5.4, sticky flags in the accumulator in 5.5, the
    round_sat and mc_pkg contracts in Section 2, the mc_lane.py API in
    Section 7, and Section 9 decisions: D-1/D-2 implemented, D-3 and D-6
    closed 2026-10-22 (e^(A+Bz) with range-reduced exp), D-4/D-5 open
    pending synthesis area.
    reports/vcs_regression_2026-10-31.txt: first VCS run of every block on
    main plus this branch - 69 model tests and 11 testbench runs, all pass.
    AGENTS.md: how to use peach (module load s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
2026-11-01 Add DC synthesis flow and gauss_lut PPA sweep on gscl45nm; close D-2
    scripts/syn/dc_synth.tcl synthesises any block/configuration from
    environment variables on the course library (FreePDK45 gscl45nm.db, the
    same file Lab 3 uses), with one shared constraint file
    (constraints/lane_5ns.sdc: 5 ns, 30% I/O budget, typical corner).
    run_sweep.sh regenerates the ROM per point and runs the ADDR_BITS x
    OUT_WIDTH grid; parse_reports.py turns the reports into
    results/gauss_lut_ppa.csv. Raw reports and mapped netlists are kept under
    reports/syn/<tag>/.
    Results (Gaussian work plan Sec. 6.1): every point closes 5 ns; area is
    96% ROM logic and tracks the model's knobs (x1.6-2 per +2 address bits,
    x1.6 for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
2026-11-01 Record shared-flow integration validation and publishing handoff
2026-11-02 Add accuracy study: hardware price vs Black-Scholes with calibrated 95% CIs
    model/price_study.py runs the bit-accurate lane model over 100 independent
    xoshiro128++ streams (separated by the canonical jump(), spec D-1) of 2^20
    trials each, for every option on the grid. Reported per option: Black-
    Scholes, the exact finite-table price, the Monte Carlo mean and standard
    error, the deterministic bias, the sampling noise of one run, and the
    coverage of the host-side 95% interval.
    Result (results/price_vs_bs.csv, docs/figures/price_vs_bs.png): bias is
    +0.002% to -0.381% across the grid, inside the 1% target and ordered as
    the tail-truncation analysis predicts; one 2^20-trial run has 0.08-0.35%
    no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
2026-11-02 Add D-5 x-width study; keep Q5.12 and document Q4.11 as the 16-bit fallback
    Exact price bias of the full fixed-point chain for A/x at Q5.12, Q5.11,
    Q5.10 and Q4.11, over ADDR_BITS 8/10/12, using price_dp's stage functions
    unchanged (the x fraction width enters through a PriceDpConfig subclass).
    Q5.12 (18 b) costs 0.01-0.05% on the grid. Q5.10 (16 b) costs up to 0.37%,
    as much as the Gaussian table's whole tail bias, because the one-time
    rounding of A is amplified by dP/dA ~ S0 N(d1). Q4.11 (also 16 b) matches
    Q5.11: exp2_unit already clamps x above 9.7 and underflows below -6.2, so
    the +-32 range of Q5 is never used. Decision: keep Q5.12; if a 16-bit x is
    ever needed for area it must be Q4.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
2026-11-02 Add reproducible waveform figures from VCS dumps
    tb/vcd_dump.sv is an optional second top that writes a VCD when run with
    +vcd=<file>; no owner's testbench changes. scripts/sim/dump_waves.sh runs
    the gauss_lut, rng_lane and price_dp testbenches with it on the lab
    machines; scripts/plot_waves.py (dependency-free VCD reader) renders the
    figures, so docs/figures/wave_*.png regenerate from `make figures` instead
    of being simulator screenshots. The VCDs themselves are gitignored.
    The price_dp figure is the II = 1 evidence for the interim report: stage
    valids one cycle apart, LAT_DP = 6 fill, and consecutive p_valid for
    consecutive z_valid. make figures also builds the accuracy figure.
2026-11-08 Add RNG stream-quality analysis and lab validation workflow
    Add reproducible model stream screening, measured tables and plots, and a long-stream RTL checker with a lab validation runner. Use the shared RNG latency constant and compile the package first in standalone build targets.
    Local validation passes 85 model tests and 13 flow tests, with two Bash-dependent tests skipped. Current-source VCS and standalone RNG synthesis remain pending.
2026-11-08 Record supplied RNG lab validation and synthesis evidence
    Import the reported Mario run manifest and PPA CSV, preserving the source transcript and evidence scope. All 79 runtime input hashes match the validated source export.
    Document the positive setup slack at 5 ns, 516 maximum-capacitance violations, and unannotated power estimate. Keep raw-log/report transfer and electrical review pending, and correct the lab path and Python environment instructions.
2026-11-08 Archive and review RNG lab simulation and synthesis reports
    Import raw VCS/DC logs, mapped reports, source/library manifests, and canonical-checked RTL stream tables with archive integrity metadata. Preserve evidence bytes in Git and retain binary design artifacts and short VCDs in the local archive.
    Verify all three full stream checksums against the independent canonical oracle, replay the recorded statistics and PPA fields, and check the short waveforms. Document the remaining capacitance/leakage diagnostics and VCS source-identification helper failure without modifying the validated runtime sources.
2026-11-09 Use standard sim and syn directories for RNG reports
    Move RNG simulation evidence and run metadata under reports/sim and flatten synthesis evidence under reports/syn. Preserve raw report bytes and historical archive member names while updating current audit paths and documentation.
    Route future validation runs to the standard layout and support parsing a single synthesis run without collecting sibling reports. Validate 85 model tests and 16 flow tests, with two Bash-dependent tests skipped; relocated PPA values remain unchanged.
2026-11-09 Simplify RNG report and result filenames
    Use descriptive RNG report directories and retain only dates in result filenames. Update runner defaults, collision checks, documentation, and archive path mappings while preserving raw evidence bytes.
    Validation: 16 flow tests passed; 2 Bash-dependent tests skipped. Moved evidence hashes match and the PPA CSV reproduces exactly.
